tonykorycki/FPGA-Keyword-Spotting-MLP/models/layer_comparison.png

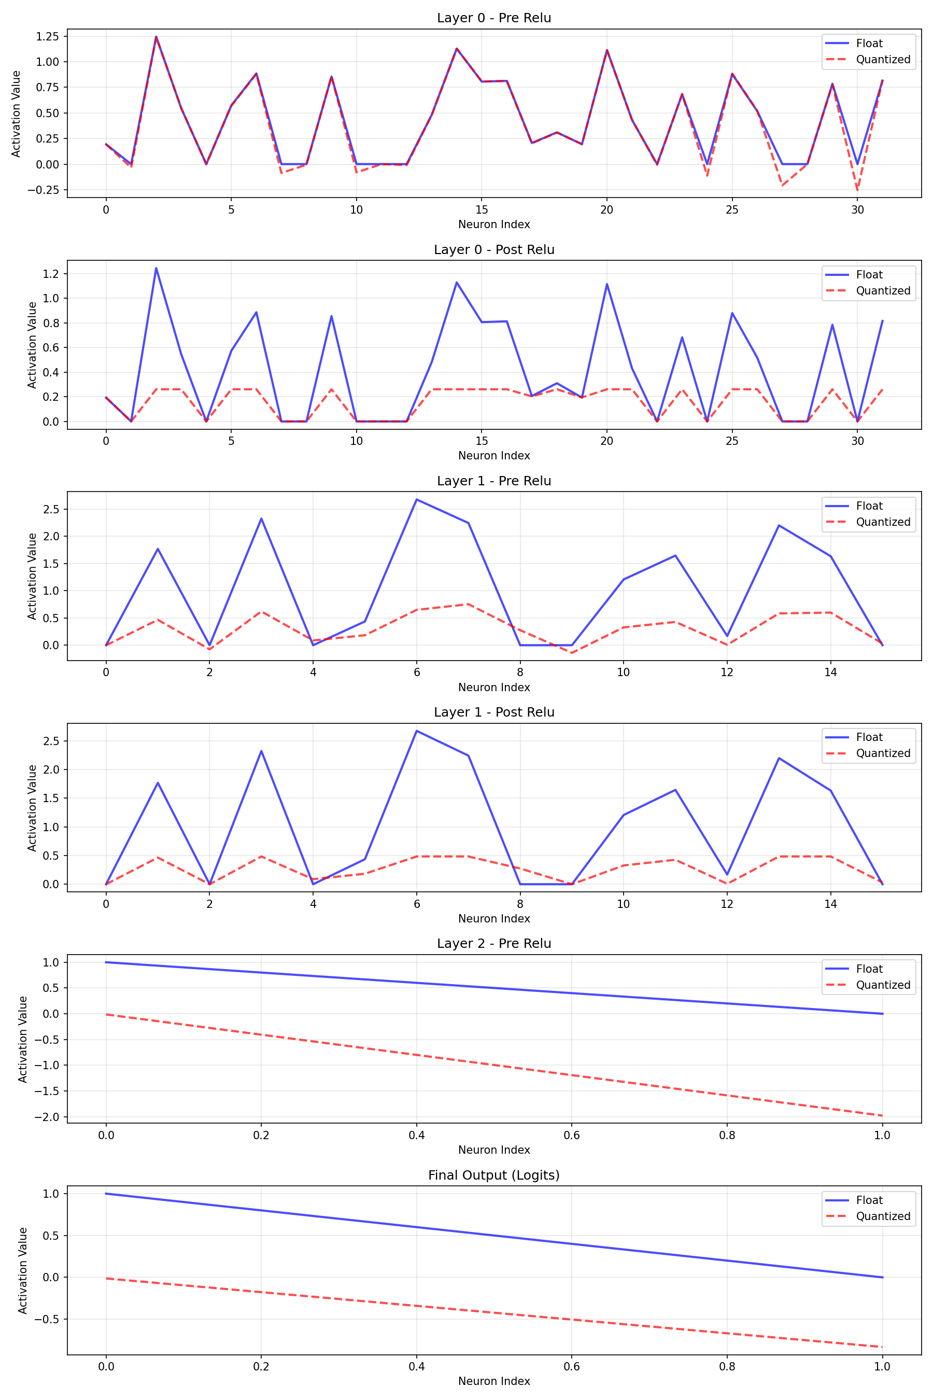
models/layer_comparison.png
