tonykorycki/FPGA-Keyword-Spotting-MLP/models/test_input_hex.txt

27
2e
24
26
36
44
3f
37
3f
39
33
33
33
31
2e
34
47
4c
49
3f
3a
44
3d
32
3e
3c
37
37
34
2f
34
39
38
3f
3c
36
37
41
42
32
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
