tonykorycki/FPGA-Keyword-Spotting-MLP/fpga/rtl/fft_core.v

//=============================================================================
// FFT Core Wrapper Module
//=============================================================================
// Wraps Xilinx FFT IP (xfft_0) with simplified interface
// Converts packed frame data to AXI-Stream, streams through FFT,
// and collects 257 complex output bins (DC + bins 1-256)
//
// Input:  512 real samples (8192 bits = 512×16)
// Output: 257 complex bins (8224 bits = 257×32, [15:0]=imag, [31:16]=real)
//
// Author: Tony Korycki
// Date: November 18, 2025
//=============================================================================

module fft_core (
    input  wire        clk,                      // System clock (100 MHz)
    input  wire        rst_n,                    // Active low reset
    
    // Input interface - serial samples
    input  wire [15:0] frame_sample,             // One sample per cycle
    input  wire        frame_sample_valid,       // Sample valid signal
    output reg         frame_consumed,           // Frame has been consumed
    
    // Output interface - packed FFT bins
    output reg [8223:0]  fft_bins_packed,        // 257 bins × 32 bits (real+imag)
    output reg           fft_done,               // FFT output ready

    // Handshake - tells frame_buffer we're ready to receive a stream
    output wire          fft_ready,
    // Backpressure - HIGH when FFT IP can accept data this cycle
    output wire          fft_data_ready,
    // Recovery - pulse HIGH if stream was lost mid-frame (safety net)
    output reg           re_stream_req
);

    //=========================================================================
    // State Machine
    //=========================================================================
    localparam STATE_IDLE        = 3'd0;
    localparam STATE_STREAM_IN   = 3'd1;
    localparam STATE_WAIT_OUTPUT = 3'd2;
    localparam STATE_COLLECT     = 3'd3;
    localparam STATE_DONE        = 3'd4;
    
    (* mark_debug = "true" *) reg [2:0] state;
    (* mark_debug = "true" *) reg [9:0] sample_counter;  // 0-511 for input, 0-511 for output

    // fft_ready: HIGH when idle and genuinely able to accept a new frame
    assign fft_ready = (state == STATE_IDLE) && config_done && data_in_tready;

    // fft_data_ready: pass through IP's tready so frame_buffer can respect backpressure
    assign fft_data_ready = data_in_tready;
    
    //=========================================================================
    // FFT IP AXI-Stream Signals
    //=========================================================================
    
    // Configuration channel (static - forward FFT, no transform length change)
    reg         config_tvalid;
    wire        config_tready;
    wire [7:0]  config_tdata = 8'h01;  // Forward FFT
    (* mark_debug = "true" *) reg         config_done;
    
    // Input data channel
    reg         data_in_tvalid;
    (* mark_debug = "true" *) wire        data_in_tready;
    reg [31:0]  data_in_tdata;
    reg         data_in_tlast;
    
    // Output data channel
    wire        data_out_tvalid;
    reg         data_out_tready;
    wire [31:0] data_out_tdata;
    wire [7:0]  data_out_tuser;  // Block floating point scale factor
    wire        data_out_tlast;
    
    // Status channel (not used but must be connected)
    wire        status_tvalid;
    reg         status_tready;
    wire [7:0]  status_tdata;
    
    // Event signals (for debugging)
    (* mark_debug = "true" *) wire event_frame_started;
    (* mark_debug = "true" *) wire event_tlast_unexpected;
    (* mark_debug = "true" *) wire event_tlast_missing;
    (* mark_debug = "true" *) wire event_status_channel_halt;
    (* mark_debug = "true" *) wire event_data_in_channel_halt;
    (* mark_debug = "true" *) wire event_data_out_channel_halt;
    
    //=========================================================================
    // Xilinx FFT IP Instantiation
    //=========================================================================
    xfft_0 fft_ip (
        .aclk(clk),
        
        // Config channel
        .s_axis_config_tdata(config_tdata),
        .s_axis_config_tvalid(config_tvalid),
        .s_axis_config_tready(config_tready),
        
        // Input data channel
        .s_axis_data_tdata(data_in_tdata),
        .s_axis_data_tvalid(data_in_tvalid),
        .s_axis_data_tready(data_in_tready),
        .s_axis_data_tlast(data_in_tlast),
        
        // Output data channel
        .m_axis_data_tdata(data_out_tdata),
        .m_axis_data_tuser(data_out_tuser),
        .m_axis_data_tvalid(data_out_tvalid),
        .m_axis_data_tready(data_out_tready),
        .m_axis_data_tlast(data_out_tlast),
        
        // Status channel
        .m_axis_status_tdata(status_tdata),
        .m_axis_status_tvalid(status_tvalid),
        .m_axis_status_tready(status_tready),
        
        // Event outputs
        .event_frame_started(event_frame_started),
        .event_tlast_unexpected(event_tlast_unexpected),
        .event_tlast_missing(event_tlast_missing),
        .event_status_channel_halt(event_status_channel_halt),
        .event_data_in_channel_halt(event_data_in_channel_halt),
        .event_data_out_channel_halt(event_data_out_channel_halt)
    );
    
    //=========================================================================
    // Output Bin Storage (257 complex bins)
    //=========================================================================
    // No async reset for RAM - enables distributed RAM inference
    reg signed [15:0] bin_real [0:256];
    reg signed [15:0] bin_imag [0:256];
    
    // Pack output bins
    integer k;
    always @(*) begin
        for (k = 0; k < 257; k = k + 1) begin
            fft_bins_packed[k*32 +: 16] = bin_imag[k];
            fft_bins_packed[k*32 + 16 +: 16] = bin_real[k];
        end
    end
    
    //=========================================================================
    // Control State Machine - Synchronous reset for RAM compatibility
    //=========================================================================
    always @(posedge clk) begin
        if (!rst_n) begin
            state <= STATE_IDLE;
            sample_counter <= 10'd0;
            config_tvalid <= 1'b1;
            config_done <= 1'b0;
            data_in_tvalid <= 1'b0;
            data_in_tdata <= 32'd0;
            data_in_tlast <= 1'b0;
            data_out_tready <= 1'b1;  // Always drain output; IP backpressures input if output stalls
            status_tready <= 1'b1;  // Always ready for status
            frame_consumed <= 1'b0;
            fft_done <= 1'b0;
            re_stream_req <= 1'b0;

        end else begin
            // Default values
            frame_consumed <= 1'b0;
            fft_done <= 1'b0;
            re_stream_req <= 1'b0;
            status_tready <= 1'b1;  // Always consume status

            // Send FFT configuration once after reset.
            if (!config_done) begin
                if (config_tready) begin
                    config_tvalid <= 1'b0;
                    config_done <= 1'b1;
                end else begin
                    config_tvalid <= 1'b1;
                end
            end
            
            case (state)
                //-------------------------------------------------------------
                STATE_IDLE: begin
                    data_in_tvalid <= 1'b0;
                    data_in_tlast <= 1'b0;

                    // Wait for FFT IP ready (tready) before starting frame input
                    if (config_done && frame_sample_valid && data_in_tready) begin
                        data_in_tdata <= {frame_sample, 16'd0};
                        data_in_tvalid <= 1'b1;
                        sample_counter <= 10'd1;
                        state <= STATE_STREAM_IN;
                    end
                end
                
                //-------------------------------------------------------------
                STATE_STREAM_IN: begin
                    // Stream 512 samples into FFT (serial input)
                    // AXI-Stream: advance only when tready accepts the sample.
                    // frame_buffer now respects backpressure via downstream_ready,
                    // so frame_sample_valid stays asserted until we accept each sample.
                    if (frame_sample_valid) begin
                        // Pack real sample with zero imaginary
                        // TDATA format: [31:16]=real, [15:0]=imag
                        if (!data_in_tvalid || data_in_tready)
                            data_in_tdata <= {frame_sample, 16'd0};
                        data_in_tvalid <= 1'b1;

                        if (data_in_tready) begin
                            if (sample_counter == 10'd511) begin
                                // Last sample accepted
                                data_in_tlast <= 1'b1;
                                frame_consumed <= 1'b1;
                                sample_counter <= 10'd0;
                                state <= STATE_WAIT_OUTPUT;
                            end else begin
                                data_in_tlast <= 1'b0;
                                sample_counter <= sample_counter + 10'd1;
                            end
                        end
                    end else if (sample_counter > 10'd0) begin
                        // Safety net: frame_sample_valid dropped mid-frame.
                        // This should not happen with the fft_ready gate + backpressure,
                        // but if it does, return to IDLE and request a re-stream rather
                        // than deadlocking. Deassert tvalid to avoid AXI protocol error.
                        data_in_tvalid <= 1'b0;
                        data_in_tlast  <= 1'b0;
                        data_in_tdata  <= 32'd0;
                        sample_counter <= 10'd0;
                        state          <= STATE_IDLE;
                        re_stream_req  <= 1'b1;
                    end else begin
                        // sample_counter == 0 and no valid — shouldn't reach here,
                        // but return to IDLE cleanly
                        data_in_tvalid <= 1'b0;
                        data_in_tlast  <= 1'b0;
                        state          <= STATE_IDLE;
                    end
                end
                
                //-------------------------------------------------------------
                STATE_WAIT_OUTPUT: begin
                    // Wait for first output
                    data_in_tvalid <= 1'b0;
                    data_in_tlast <= 1'b0;
                    if (data_out_tvalid) begin
                        state <= STATE_COLLECT;
                        sample_counter <= 10'd0;
                    end
                end
                
                //-------------------------------------------------------------
                STATE_COLLECT: begin
                    // Collect 257 output bins (0-256)
                    if (data_out_tvalid && data_out_tready) begin
                        // Store real and imaginary parts
                        // TDATA format: [31:16]=real, [15:0]=imag
                        if (sample_counter < 257) begin
                            bin_real[sample_counter] <= data_out_tdata[31:16];
                            bin_imag[sample_counter] <= data_out_tdata[15:0];
                        end
                        
                        if (data_out_tlast || sample_counter == 10'd256) begin
                            // Done collecting (either TLAST or 257 bins)
                            // data_out_tready stays 1 — remaining bins (257-511) drain automatically
                            state <= STATE_DONE;
                        end else begin
                            sample_counter <= sample_counter + 10'd1;
                        end
                    end
                end
                
                //-------------------------------------------------------------
                STATE_DONE: begin
                    fft_done <= 1'b1;
                    state <= STATE_IDLE;
                end
                
                //-------------------------------------------------------------
                default: begin
                    state <= STATE_IDLE;
                end
            endcase
        end
    end

endmodule
 
