tonykorycki/FPGA-Keyword-Spotting-MLP/(commit log)

2026-01-14 combined wirghts for bram inference
2026-01-14 minor timing fixes in feat avger and extractor
    [feature_averager.v]
2026-01-14 ensure sync resets across modules
    [feature_averager.v, fft_core.v, frame_buffer.v, inference.v, inference_bram.v]
2026-02-13 fixed clocking, stretched LED pulses
    [basys3.xdc, i2s_rx.v, i2s_test.xdc, ila_to_wav.py, inference.v, top.v]
2026-02-13 made all resets sync
    [inference.v, top.v]
2026-02-13 fixed AXI-S in fft_core
    [fft_core.v, frame_buffer.v]
2026-04-05 wip: added more debug markers and some testbenches for the handshake bug
    [fft_core.v, frame_buffer.v, tb_handshake_chain.v, xfft_0_stub.v]
2026-04-05 wip: add extra connectiosn to fft core and frame buffer to narrow down the handshake issue.
    [fft_core.v, frame_buffer.v, tb_handshake_chain.v, top.v]
